baochip/cw308t-baochip/README.md

# Chipwhisperer 308 Target for Baochip

Design files for a chipwhisperer 308 target featuring the Baochip.

Contains a 400MHz bandwidth, 20x amplifier on IDD.

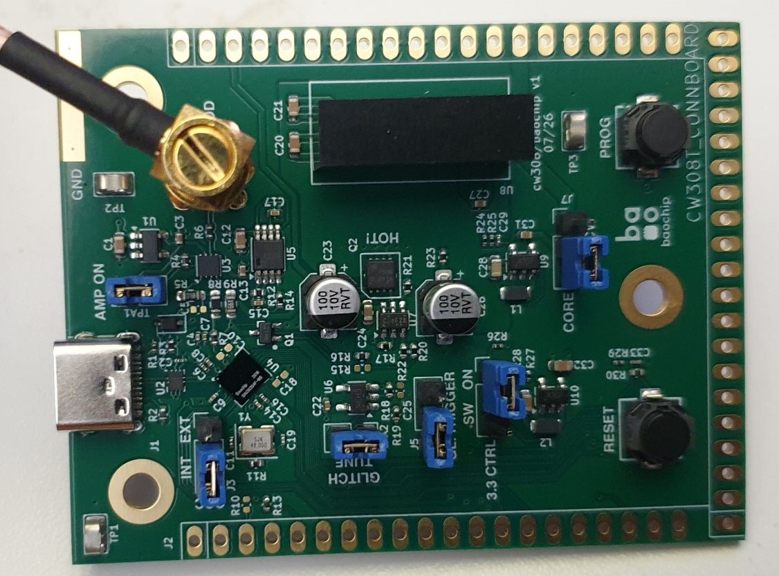
[picture p1: cw308t-baochip.jpg]
CW308T target for Baochip
