baochip/cw308t-baochip/CW308T_BAOCHIP.pdf

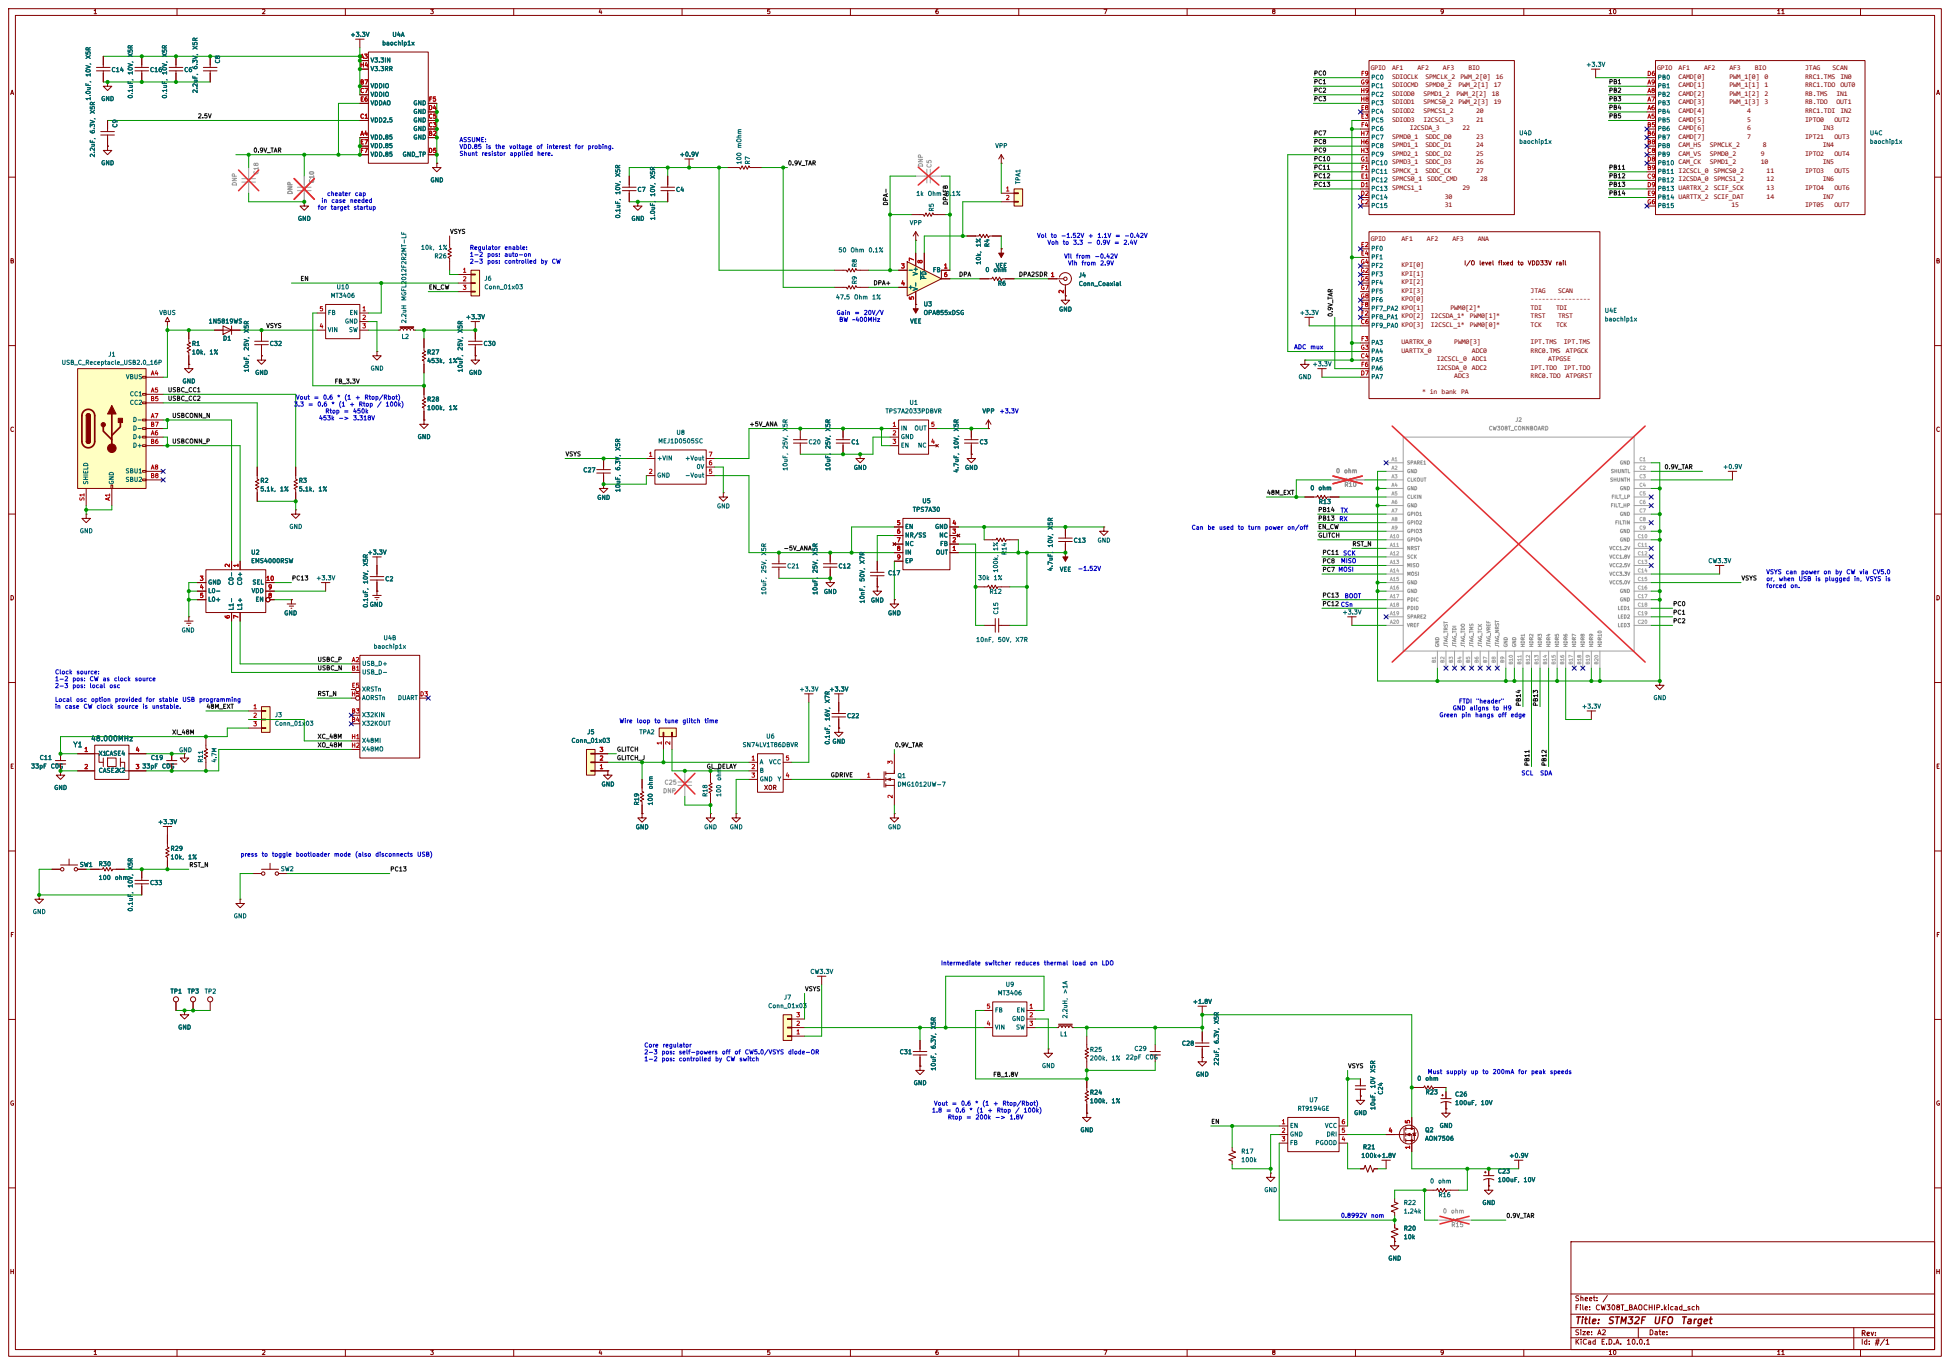
[picture p2: page 1]

ASSUME: VDD.85 is the voltage of interest for probing. Shunt resistor applied here.

Regulator enable: 1-2 pos: auto-on 2-3 pos: controlled by CW

IPT.TMS
RRC0.TMS ATPGCK
ATPGSE
IPT.TDO

Vout = 0.6 * (1 + Rtop/Rbot) 3.3 = 0.6 * (1 + Rtop / 100k)

FTDI "header" GND aligns to H9 Green pin hangs off edge Can be used to turn power on/off

VSYS can power on by CW via CV5.0
or, when USB is plugged in, VSYS is

forced on. BOOT Clock source: 1-2 pos: CW as clock source 2-3 pos: local osc

1-2 pos: controlled by CW switch Wire loop to tune glitch time

Local osc option provided for stable USB programming
in case CW clock source is unstable.

press to toggle bootloader mode (also disconnects USB)

Intermediate switcher reduces thermal load on LDO

Core regulator 2-3 pos: self-powers off of CW5.0/VSYS diode-OR

Must supply up to 200mA for peak speeds
0 ohm

Vout = 0.6 * (1 + Rtop/Rbot) 1.8 = 0.6 * (1 + Rtop / 100k)

Size: A2 | Rev:
KiCad E.D.A. 10.0.1 | Id: #/1
