baochip/cw308t-baochip/CW308T_BAOCHIP.kicad_pcb

## KiCad design CW308T_BAOCHIP.kicad_pcb (2026-10-08)

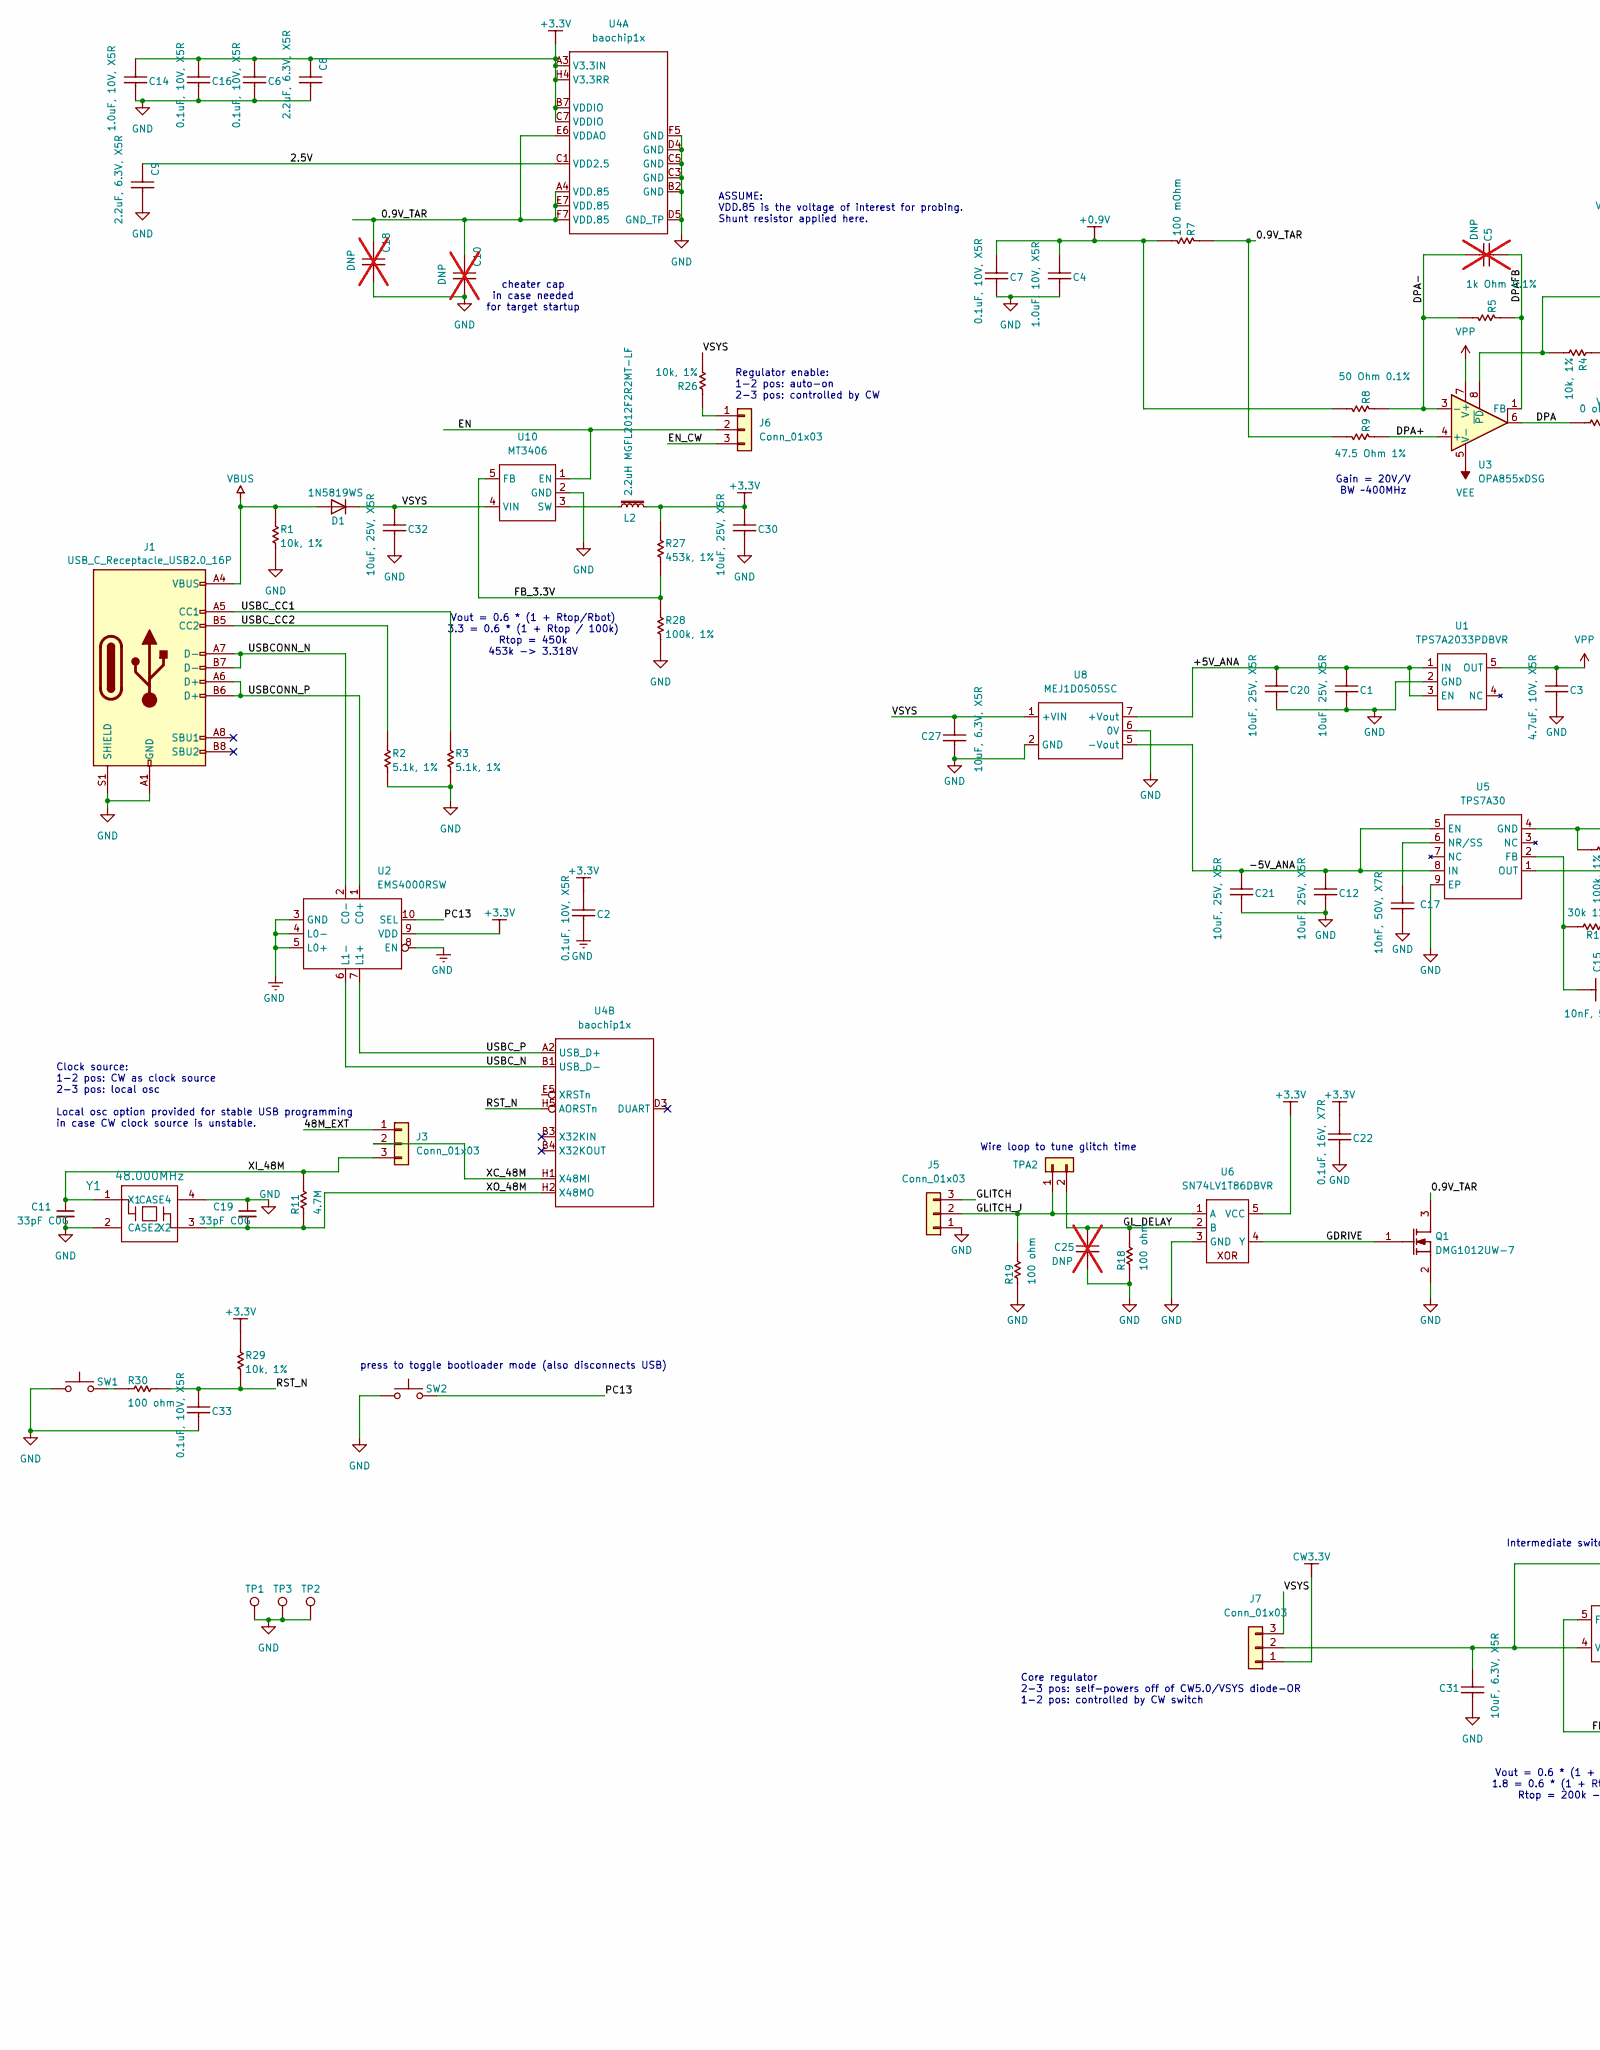
[picture p3: schematic CW308T_BAOCHIP.kicad_sch, STM32F UFO Target, part in row 1, column 1]

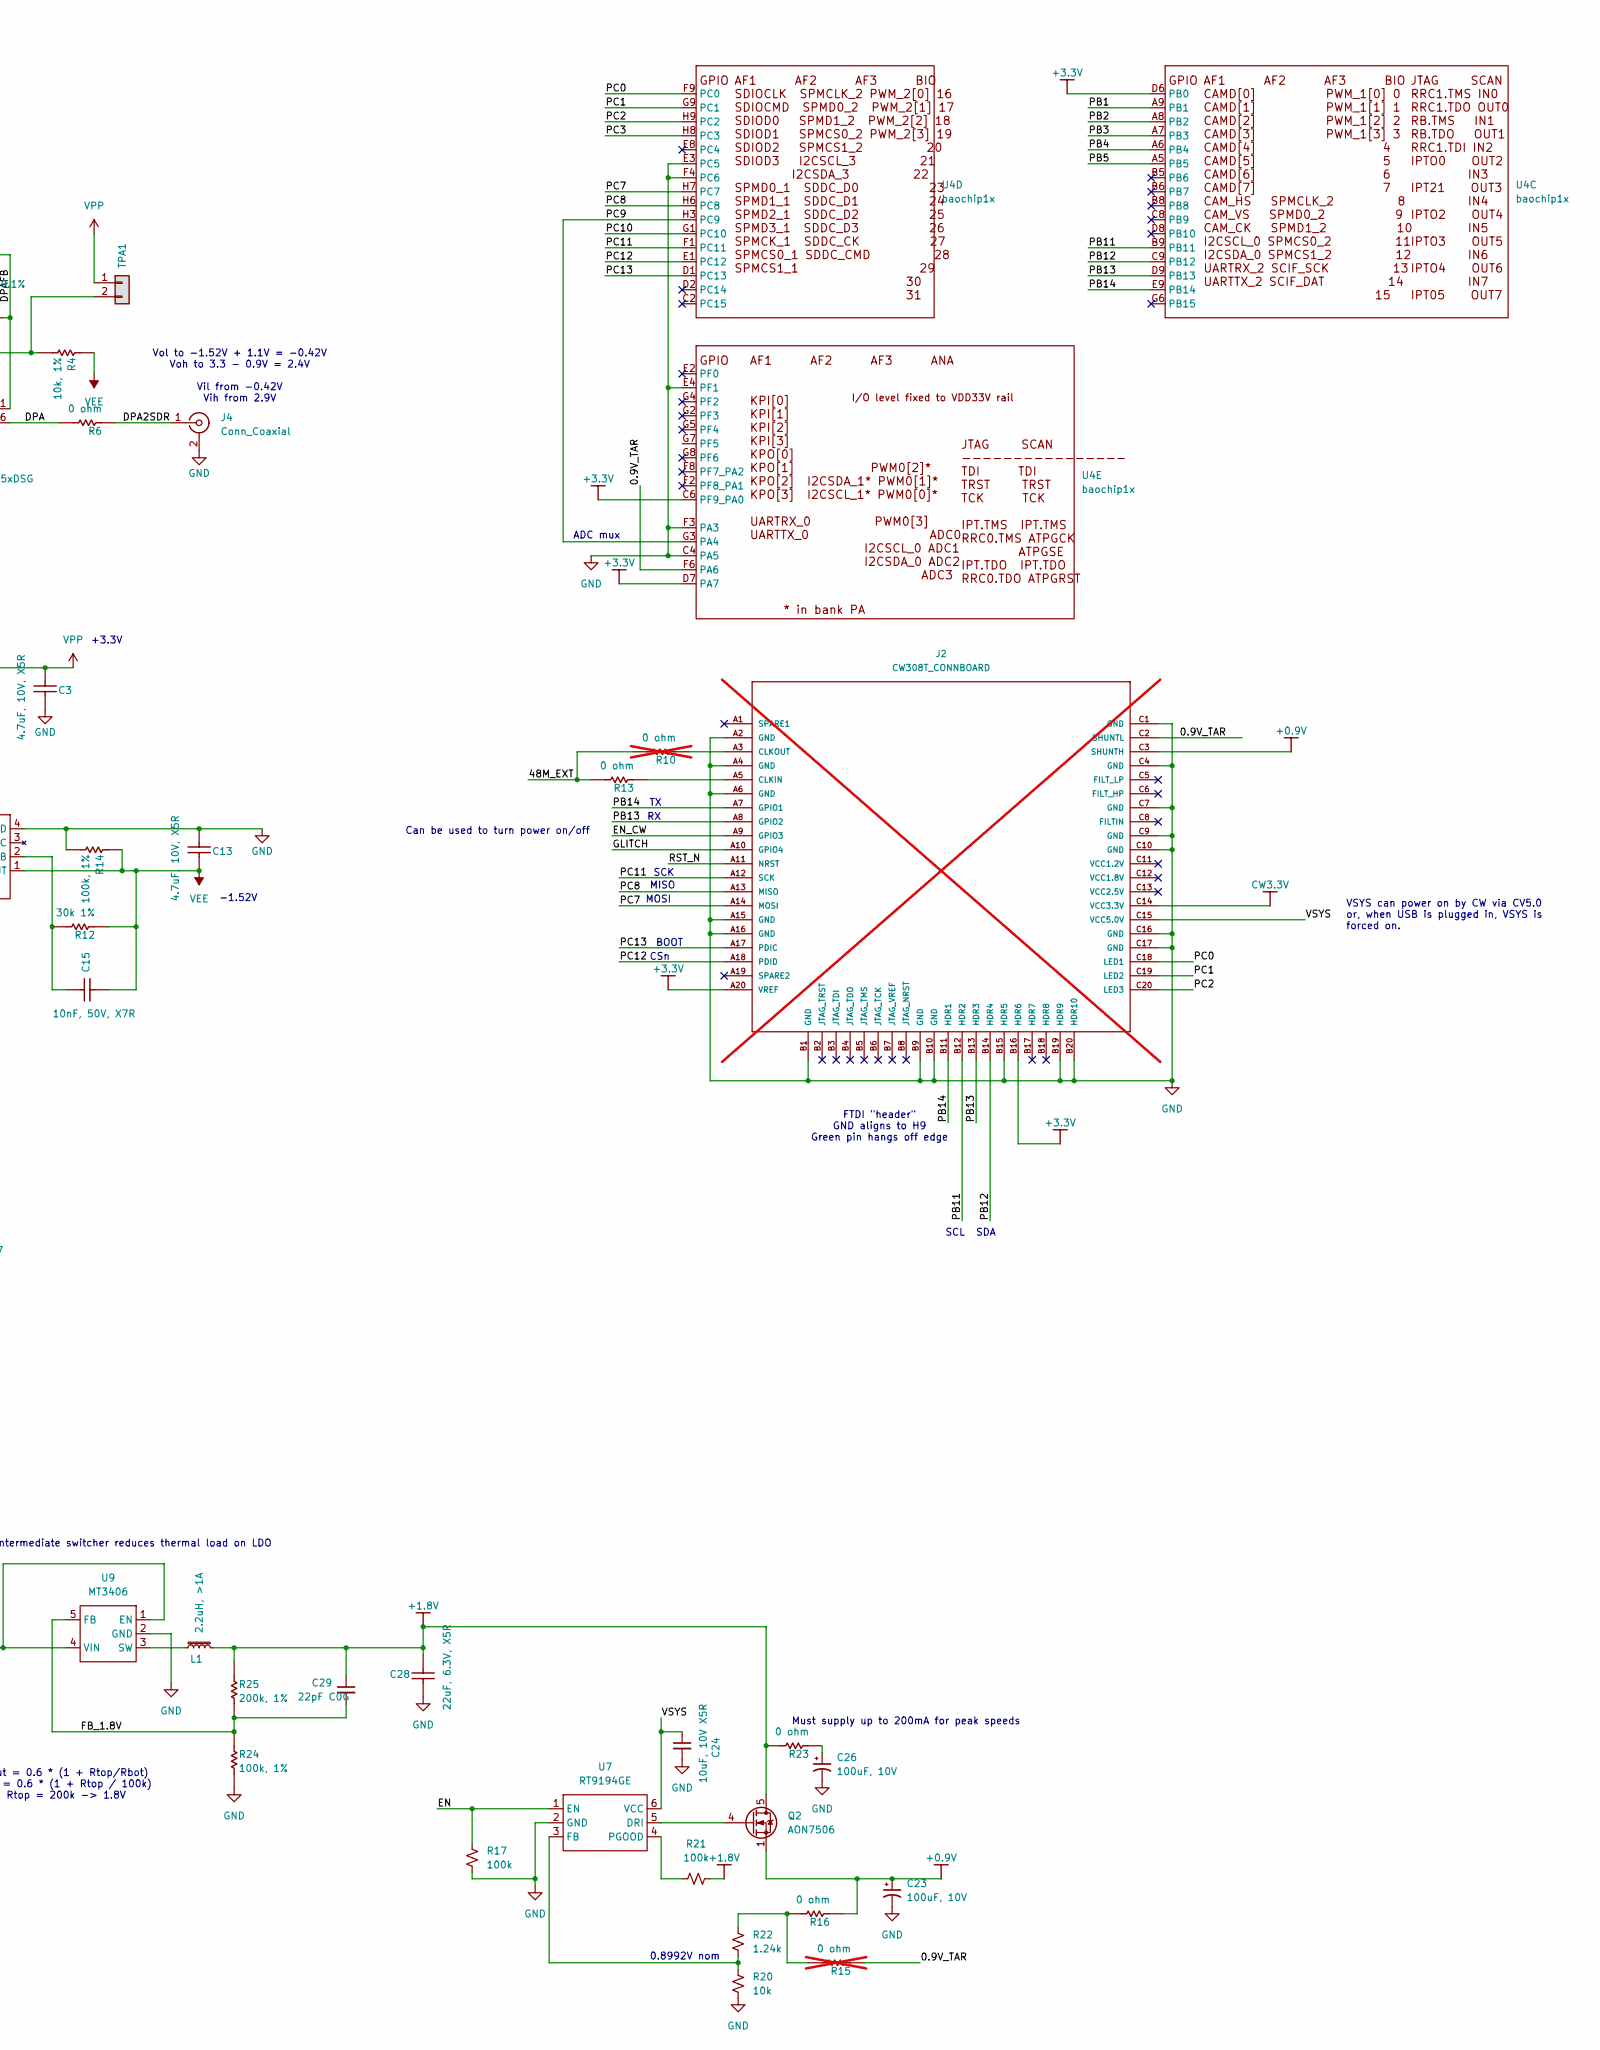
[picture p4: schematic CW308T_BAOCHIP.kicad_sch, STM32F UFO Target, part in row 1, column 2]

Parts:
C1, C12, C20, C21, C30, C32: 10uF, 25V, X5R; C_0603_1608Metric; MPN CL10A106MA8NRNC; LCSC C96446
C2, C6, C7, C16, C33: 0.1uF, 10V, X5R; C_0201_0603Metric; MPN CL05B104KO5NNNC; LCSC C76934
C3, C13: 4.7uF, 10V, X5R; C_0402_1005Metric; MPN CL05A475MP5NRNC; LCSC C23733
C4, C14: 1.0uF, 10V, X5R; C_0201_0603Metric; MPN CL05A105KA5NQNC; LCSC C76935
C5, C25: DNP; C_0402_1005Metric; MPN DNP; LCSC DNP; not fitted
C8, C9: 2.2uF, 6.3V, X5R; C_0201_0603Metric; MPN GRM033R60J225ME47D; LCSC C76933
C10, C18: DNP; C_0402_1005Metric_Pad0.74x0.62mm_HandSolder; LCSC DNP; not fitted
C11, C19: 33pF C0G; C_0201_0603Metric; LCSC C56903
C15, C17: 10nF, 50V, X7R; C_0402_1005Metric; MPN CC0402KRX7R9BB103; LCSC C60133
C22: 0.1uF, 16V, X7R; C_0402_1005Metric; MPN CL05B104KO5NNNC; LCSC C1525
C23, C26: 100uF, 10V; CP_Elec_5x5.4; LCSC C131115
C24: 10uF, 10V X5R; C_0603_1608Metric; LCSC C19702
C27, C31: 10uF, 6.3V, X5R; C_0402_1005Metric; MPN CL05A106MQ5NUNC; LCSC C15525
C28: 22uF, 6.3V, X5R; C_0603_1608Metric; MPN CL10A226MQ8NRNC; LCSC C59461
C29: 22pF C0G; C_0201_0603Metric; Rating C0G 50V 0201; MPN ANY; LCSC C57783
D1: 1N5819WS; D_SOD-323; MPN SD103AWS; LCSC C191023
J1: USB_C_Receptacle_USB2.0_16P; USB_C_Receptacle_HRO_TYPE-C-31-M-12; LCSC C165948
J2: CW308T_CONNBOARD; not fitted
J3, J5, J6, J7: Conn_01x03; PinHeader_1x03_P2.54mm_Vertical; LCSC C2937625
J4: Conn_Coaxial; SMA_Amphenol_901-144_Vertical; LCSC C496549
L1: 2.2uH, >1A; L_0805_2012Metric; LCSC C42455261
L2: 2.2uH MGFL2012F2R2MT-LF; L_0805_2012Metric; LCSC C281115
Q1: DMG1012UW-7; SOT323-3AN; MPN DMG1012UW-7; LCSC C156390
Q2: AON7506; AO_DFN3x3A_8L_EP1_P; LCSC C485678
R1, R26, R29: 10k, 1%; R_0201_0603Metric; MPN ANY; LCSC C106225
R2, R3: 5.1k, 1%; R_0402_1005Metric; MPN ANY; LCSC C25905
R4: 10k, 1%; R_0402_1005Metric; MPN ANY; LCSC C25744
R5: 1k Ohm 0.1%; R_0603_1608Metric_Pad0.98x0.95mm_HandSolder; MPN TBD; LCSC C110776
R6, R13, R16, R23: 0 ohm; R_0402_1005Metric; MPN ANY; LCSC C17168
R7: 100 mOhm; R_0402_1005Metric; MPN TBD; LCSC C270655
R8: 50 Ohm 0.1%; R_0603_1608Metric_Pad0.98x0.95mm_HandSolder; MPN TBD; LCSC C849792
R9: 47.5 Ohm 1%; R_0603_1608Metric_Pad0.98x0.95mm_HandSolder; MPN TBD; LCSC C23062
R10, R15: 0 ohm; R_0402_1005Metric; MPN ANY; LCSC C17168; not fitted
R11: 4.7M; R_0402_1005Metric; MPN ANY; LCSC C474132
R12: 30k 1%; R_0402_1005Metric; MPN ANY; LCSC C138008
R14: 100k, 1%; R_0402_1005Metric; MPN ANY; LCSC C25741
R17, R21: 100k; R_0402_1005Metric; LCSC C60491
R18, R19, R30: 100 ohm; R_0402_1005Metric; MPN ANY; LCSC C106232
R20: 10k; R_0402_1005Metric; LCSC C60490
R22: 1.24k; R_0402_1005Metric; LCSC C274889
R24, R28: 100k, 1%; R_0201_0603Metric; MPN ANY; LCSC C106224
R25: 200k, 1%; R_0201_0603Metric; MPN ANY; LCSC C138163
R27: 453k, 1%; R_0201_0603Metric; MPN ANY; LCSC C423509
SW1, SW2: SW_Push; PANASONIC_EVPAS; MPN EVPAS; LCSC C4365033
TP1, TP2, TP3: TestPoint; TestPoint_Keystone_5015_Micro_Mini; LCSC C3345122
TPA1, TPA2: Conn_01x02; PinHeader_1x02_P2.54mm_Vertical; LCSC C225477
U1: TPS7A2033PDBVR; SOT-23-5; MPN TPS7A2033PDBVR; LCSC C2862740
U2: EMS4000RSW; QFN-10_1.4x1.8_Pitch0.4mm; LCSC C49186227
U3: OPA855xDSG; WSON-8-1EP_2x2mm_P0.5mm_EP0.9x1.6mm; LCSC C2866497
U4: baochip1x; WLCSP-71_9x8_4.062x3.762mm
U5: TPS7A30; HVSSOP-8-1EP_3x3mm_P0.65mm_EP1.57x1.89mm_ThermalVias; MPN TPS7A3001DGNR; LCSC C33835
U6: SN74LV1T86DBVR; SOT-23-5_HandSoldering; MPN SN74LV1T86DBVR; LCSC C2682145
U7: RT9194GE; SOT-23-6; LCSC C17239326
U8: MEJ1D0505SC; MEJ1DxxxxSC; MPN MEJ1D0505SC; LCSC C5369550
U9, U10: MT3406; SOT-23-5; LCSC C22462728
Y1: 48.000MHz; Crystal_SMD_3225-4Pin_3.2x2.5mm; LCSC C2892060

Connections:
+0.9V: C4.1, C7.1, C23.1, J2.C3 (SHUNTH), Q2.1 (S), Q2.2 (S), Q2.3 (S), R7.1, R8.1, R16.1
+1.8V: C28.2, C29.1, L1.2, Q2.5 (D), R21.2, R23.2, R25.1
+3.3V: C2.1, C6.1, C8.1, C14.1, C16.1, C22.1, C30.1, J2.A20 (VREF), J2.B16 (HDR6), L2.2, R27.1, R29.1, U2.9 (VDD), U4.A3 (V3.3IN), U4.B7 (VDDIO), U4.C6 (PF9_PA0), U4.C7 (VDDIO), U4.D6 (PB0), U4.D7 (PA7), U4.H4 (V3.3RR), U6.5 (VCC)
/0.9V_TAR: C10.1, C18.1, J2.C2 (SHUNTL), Q1.3 (D), R7.2, R9.1, R15.1, U4.A4 (VDD.85), U4.E6 (VDDAO), U4.E7 (VDD.85), U4.F6 (PA6), U4.F7 (VDD.85)
/2.5V: C9.1, U4.C1 (VDD2.5)
/48M_EXT: J3.1, R10.2, R13.2
/+5V_ANA: C1.1, C20.1, U1.1 (IN), U1.3 (EN), U8.7 (+Vout)
/-5V_ANA: C12.1, C21.1, U5.5 (EN), U5.8 (IN), U8.5 (-Vout)
/DPA: R6.2, U3.6
/DPA2SDR: J4.1 (In), R6.1
/DPA+: R9.2, U3.4 (+)
/DPA-: C5.1, R5.1, R8.2, U3.3 (-)
/DPAFB: C5.2, R5.2, U3.1 (FB)
/EN: J6.2, R17.2, U7.1 (EN), U10.1 (EN)
/EN_CW: J2.A9 (GPIO3), J6.3
/FB_1.8V: C29.2, R24.1, R25.2, U9.5 (FB)
/FB_3.3V: R27.2, R28.1, U10.5 (FB)
/GDRIVE: Q1.1 (G), U6.4 (Y)
/GLITCH: J2.A10 (GPIO4), J5.3
/GLITCH_J: J5.2, R19.2, TPA2.1, U6.1 (A)
/GL_DELAY: C25.2, R18.2, TPA2.2, U6.2 (B)
/PB1: U4.A9 (PB1)
/PB2: U4.A8 (PB2)
/PB3: U4.A7 (PB3)
/PB4: U4.A6 (PB4)
/PB5: U4.A5 (PB5)
/PB11: J2.B12 (HDR2), U4.B9 (PB11)
/PB12: J2.B14 (HDR4), U4.C9 (PB12)
/PB13: J2.A8 (GPIO2), J2.B13 (HDR3), U4.D9 (PB13)
/PB14: J2.A7 (GPIO1), J2.B11 (HDR1), U4.E9 (PB14)
/PC0: J2.C18 (LED1), U4.F9 (PC0)
/PC1: J2.C19 (LED2), U4.G9 (PC1)
/PC2: J2.C20 (LED3), U4.H9 (PC2)
/PC3: U4.H8 (PC3)
/PC7: J2.A14 (MOSI), U4.H7 (PC7)
/PC8: J2.A13 (MISO), U4.H6 (PC8)
/PC9: U4.G3 (PA4), U4.H3 (PC9)
/PC10: U4.G1 (PC10)
/PC11: J2.A12 (SCK), U4.F1 (PC11)
/PC12: J2.A18 (PDID), U4.E1 (PC12)
/PC13: J2.A17 (PDIC), SW2.2, U2.10 (SEL), U4.D1 (PC13)
/RST_N: C33.1, J2.A11 (NRST), R29.2, R30.2, U4.H5 (AORSTn)
/USBCONN_N: J1.A7 (D-), J1.B7 (D-), U2.2 (C0-)
/USBCONN_P: J1.A6 (D+), J1.B6 (D+), U2.1 (C0+)
/USBC_CC1: J1.A5 (CC1), R3.2
/USBC_CC2: J1.B5 (CC2), R2.2
/USBC_N: U2.6 (L1-), U4.B1 (USB_D-)
/USBC_P: U2.7 (L1+), U4.A2 (USB_D+)
/VSYS: C24.1, C27.2, C32.1, D1.1 (K), J2.C15 (VCC5.0V), J7.3, R26.2, U7.6 (VCC), U8.1 (+VIN), U10.4 (VIN)
/XC_48M: J3.2, U4.H1 (X48MI)
/XI_48M: C11.1, J3.3, R11.2, Y1.1 (X1)
/XO_48M: C19.2, R11.1, U4.H2 (X48MO), Y1.3 (X2)
CW3.3V: J2.C14 (VCC3.3V), J7.1
GND: C1.2, C2.2, C3.2, C4.2, C6.2, C7.2, C8.2, C9.2, C10.2, C11.2, C12.2, C13.1, C14.2, C16.2, C17.2, C18.2, C19.1, C20.2, C21.2, C22.2, C23.2, C24.2, C25.1, C26.2, C27.1, C28.1, C30.2, C31.1, C32.2, C33.2, J1.A1 (GND), J1.A12 (GND), J1.B1 (GND), J1.B12 (GND), J1.S1 (SHIELD), J2.A2 (GND), J2.A4 (GND), J2.A6 (GND), J2.A15 (GND), J2.A16 (GND), J2.B1 (GND), J2.B9 (GND), J2.B10 (GND), J2.B15 (HDR5), J2.B19 (HDR9), J2.B20 (HDR10), J2.C1 (GND), J2.C4 (GND), J2.C7 (GND), J2.C9 (GND), J2.C10 (GND), J2.C16 (GND), J2.C17 (GND), J4.2 (Ext), J5.1, Q1.2 (S), R1.2, R2.1, R3.1, R14.1, R17.1, R18.1, R19.1, R20.2, R24.2, R28.2, SW1.1, SW2.1, TP1.1 (1_1), TP2.1 (1_1), TP3.1 (1_1), U1.2 (GND), U2.3 (GND), U2.4 (L0-), U2.5 (L0+), U2.8 (EN), U4.B2 (GND), U4.C3 (GND), U4.C4 (PA5), U4.C5 (GND), U4.D4 (GND), U4.D5 (GND_TP), U4.E3 (PC5), U4.E4 (PF1), U4.F3 (PA3), U4.F4 (PC6), U4.F5 (GND), U5.4 (GND), U5.9 (EP), U6.3 (GND), U7.2 (GND), U8.2 (GND), U8.6 (0V), U9.2 (GND), U10.2 (GND), Y1.2 (CASE2), Y1.4 (CASE4)
unnamed: C26.1, R23.1
unnamed: J2.A5 (CLKIN), R13.1
unnamed: J2.A3 (CLKOUT), R10.1
unnamed: J6.1, R26.1
unnamed: C31.2, J7.2, U9.1 (EN), U9.4 (VIN)
unnamed: Q2.4 (G), U7.5 (DRI)
unnamed: R15.2, R16.2, R22.1
unnamed: R30.1, SW1.2
unnamed: R4.2, TPA1.2, U3.8 (~PD)
unnamed: C15.1, R12.2, U5.2 (FB)
unnamed: C17.1, U5.6 (NR/SS)
unnamed: R20.1, R22.2, U7.3 (FB)
unnamed: R21.1, U7.4 (PGOOD)
unnamed: L1.1, U9.3 (SW)
unnamed: L2.1, U10.3 (SW)
VBUS: D1.2 (A), J1.A4 (VBUS), J1.A9 (VBUS), J1.B4 (VBUS), J1.B9 (VBUS), R1.1
VEE: C13.2, C15.2, R4.1, R12.1, R14.2, U3.5 (V-), U3.9 (V-), U5.1 (OUT)
VPP: C3.1, TPA1.1, U1.5 (OUT), U3.7 (V+)

Notes on the sheet:
SCK
press to toggle bootloader mode (also disconnects USB)
0.8992V nom
Vout = 0.6 * (1 + Rtop/Rbot) 1.8 = 0.6 * (1 + Rtop / 100k) Rtop = 200k -> 1.8V
Core regulator 2-3 pos: self-powers off of CW5.0/VSYS diode-OR 1-2 pos: controlled by CW switch
+3.3V
Must supply up to 200mA for peak speeds
Wire loop to tune glitch time
Gain = 20V/V BW ~400MHz
Regulator enable: 1-2 pos: auto-on 2-3 pos: controlled by CW
Vout = 0.6 * (1 + Rtop/Rbot) 3.3 = 0.6 * (1 + Rtop / 100k) Rtop = 450k 453k -> 3.318V
MISO
VSYS can power on by CW via CV5.0 or, when USB is plugged in, VSYS is forced on.
Clock source: 1-2 pos: CW as clock source 2-3 pos: local osc Local osc option provided for stable USB programming in case CW clock source is unstable.
cheater cap in case needed for target startup
ASSUME: VDD.85 is the voltage of interest for probing. Shunt resistor applied here.
BOOT
Can be used to turn power on/off
Intermediate switcher reduces thermal load on LDO
Vol to -1.52V + 1.1V = -0.42V Voh to 3.3 - 0.9V = 2.4V Vil from -0.42V Vih from 2.9V
ADC mux
MOSI
FTDI "header" GND aligns to H9 Green pin hangs off edge
SDA
-1.52V
SCL
CSn

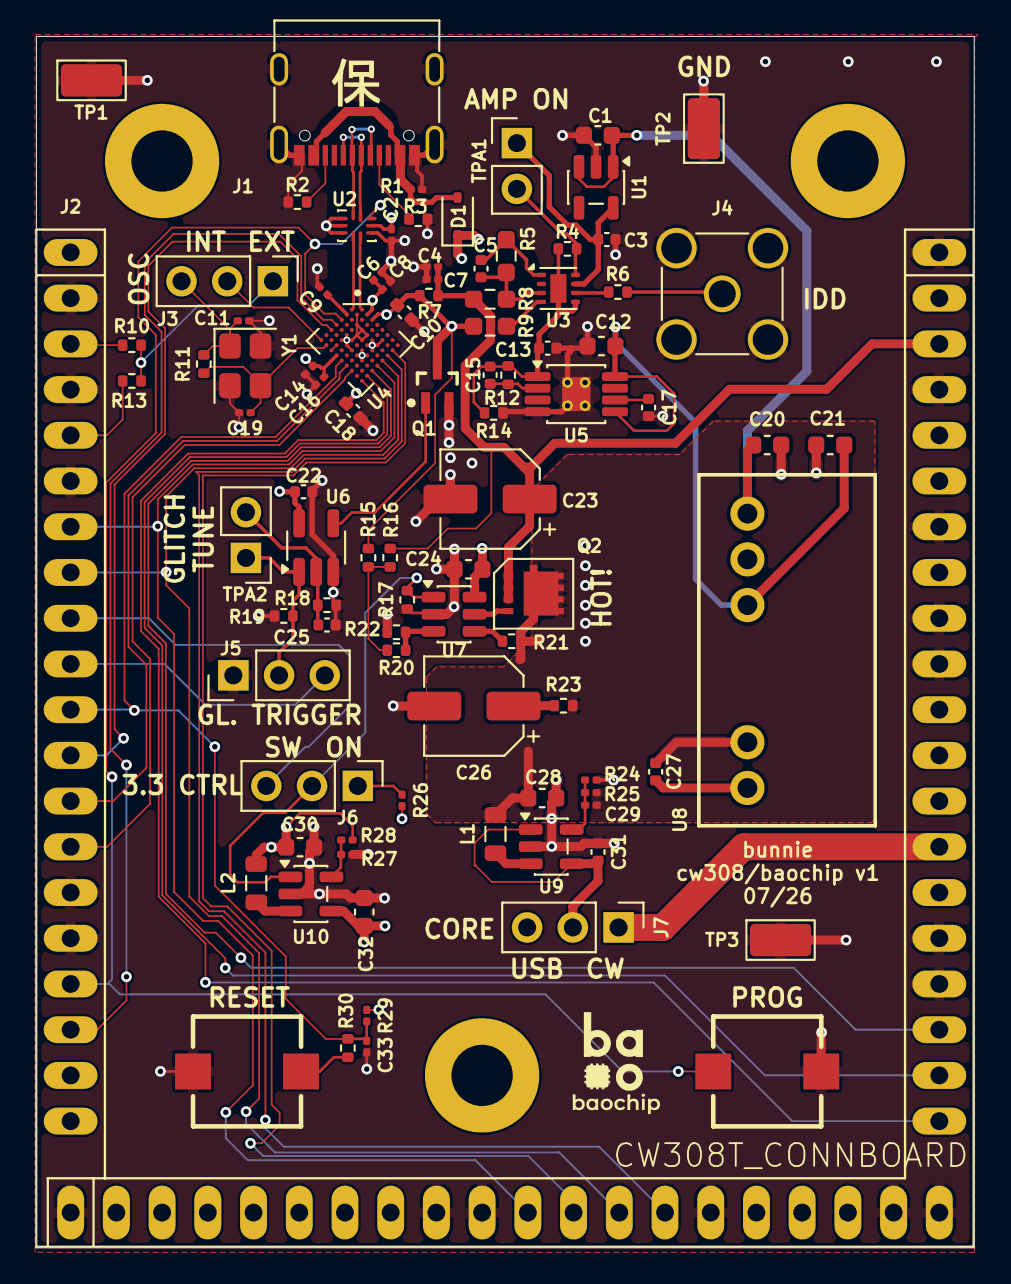
[picture p5: board CW308T_BAOCHIP.kicad_pcb from above]

Board: 4 copper layers, 52.1 x 67.3 mm, 93 parts (0 on the bottom side), 65 nets.
